Tobiasfonseca/Early-Fire-Detection-System/README.md

# Early-Fire-Detection-System
Sistema para detección temprana de incendios.
