Tobiasfonseca/Early-Fire-Detection-System/Informe_EFDS.pdf

Diseno de Sistema para la Detecci ˜ | on Temprana de ´ Incendios Forestales

Tobías Fonseca Cruz
Escuela de Ingeniería Electronica ´ Instituto Tecnologico de Costa Rica ´ Cartago, Costa Rica
tobiasfonsecac@gmail.com

Resumen—El informe presenta el desarrollo y resultados de
la primer version de un sistema para la detecci ´ | on temprana de ´
incendios forestales. Utiliza sensores de gases, humedad relativa y temperatura, y es alimentado por una batería de litio. Mediante un ESP32 se suben los datos a una base de datos en caso de
exceder los parametros definidos. El sistema funcion ´ | o seg ´ | un lo ´
esperado y da paso a una siguiente version que busque ser ´ mas eficiente en el consumo de potencia y buscar mejoras en ´ el programa y el PCB.

Palabras Clave—DHT22, DS18B20, ESP32, MQ2, WiFi

I. INTRODUCCION´

La Comision Nacional de Emergencias (CNE) define un ´ incendio forestal como un fuego que se propaga sin control
a traves de vegetaci ´ | on rural o urbana y pone en peligro a las ´
personas, los bienes y el medio ambiente, estos constituyen
la causa mas importante de destrucci ´ | on de bosques [1]. En ´
ocasiones pueden durar poco tiempo, sin embargo si se presentan las condiciones adecuadas el incendio puede ser de gran magnitud y propagarse rapidamente [2]. ´
El inicio de un incendio forestal puede ser de 3 orígenes: forma malintencionada, fortuitamente o natural. La mayoría de las veces se dan como consecuencia de acciones humanas tales como deforestacion, agricultura y negligencia. Dentro de ´ las repercusiones de los incendios forestales se encuentran la
emision de gran cantidad de contaminantes, holl ´ | ín que puede
ser transportado grandes distancias y generar que los sumideros de carbono se conviertan en fuentes de gas invernadero [2].
Debido a la crisis climatica, se espera que para el 2050 ´ la cantidad de incendios forestales aumente en un 30 %, por lo que se hace un llamado a los gobiernos para implementar
estrategias de prevencion, preparaci ´ | on y asignar presupuestos ´
adecuadamente ante tal fenomeno. Los pa ´ | íses pobres se ven
afectados de gran manera por la poca capacidad de respuesta y por el alto costo de la reconstruccion de las zonas afectadas ´ [3].
El Sistema de Alerta Temprana de Incendios Forestales (SATIF) del Instituto Meteorologico Nacional de Costa Rica ´ permite evaluar variables que afectan la probable ocurrencia y potencial comportamiento del fuego. El proyecto surge de la donacion del Fondo Cooperativo para el Carbono de los ´ Bosques (FCPF) y ademas de obtener las condiciones de ´
riesgo, busca crear una cultura y educacion en la poblaci ´ | on´
para evitar la ocurrencia de incendios. El SATIF es capaz de medir la temperatura, la humedad relativa, velocidad del viento y cantidad de lluvia. Segun estas variables, clasifica el riesgo ´ de un potencial incendio para predecir características como la velocidad de avance, altura de las llamas, entre otros [4].
El sistema pretende mejorar las soluciones existentes anadiendo la capacidad de detectar gases producidos por ˜ la combustion de los incendios forestales. Busca ser una ´
alternativa de bajo costo, autonoma y de f ´ | acil integraci ´ | on´
que permita ser instalada en zonas propensas a incendios por entidades como bomberos u organizaciones interesadas.

II. METODOLOGÍA

A continuacion, se dar ´ | a una descripci ´ | on detallada del dise ´ | nõ
y seleccion de componentes para la medici ´ | on de variables, ´
transmision de la informaci ´ | on y distribuci ´ | on de potencia. ´

II-A. Sensores
Las variables por medir corresponden a temperatura, humedad relativa y gases provocados en incendios.
Temperatura: El sensor DS18B20 permite medir temperatura con una resolucion de 9 (0.5°C) a 12 bits ´ (0.0625°C), un rango de medicion de -55°C hasta ´ +125°C, fuente de voltaje de 3 a 5.5V. Este sensor trabaja con el protocolo 1-Wire, cuya salida digital se conecta a Vcc mediante una resistencia de pull-up. Para mas detalles ´ consultar su hoja de datos. (https://dlnmh9ip6v2uc.cloudfront.net/datasheets/Sensors/Temp/DS18B20.pdf)
Humedad relativa: El sensor DHT22 permite medir la
humedad relativa con una precision de ´ | ±2 % y una
resolucion de ´ | ±0.1 %. Es capaz de trabajar con fuentes de
3.3 a 6V. Ademas, permite leer temperatura sin embargo ´ con una resolucion menor comparada al DS18B20 ante- ´ riormente mencionado. El sensor transmite datos a traves´ de una salida digital conectada a Vcc con una resistencia
de pull-up. Para mas detalles consultar su ´ | hoja de datos. (https://cdn-shop.adafruit.com/datasheets/DHT22.pdf)
Gases: Algunos de los contaminantes que se emiten
durante la combustion de biomasa corresponden a di ´ | oxi- ´
do de carbono, monoxido de carbono, metano, hidro- ´ carbonos y partículas de humo [5]. Por tanto, se opta por el sensor MQ2, el cual es sensible a gases como alcohol, propano, monoxido de carbono, metano, gas ´ LPG y humo. El sensor opera a 5V y necesita de un precalentamiento recomendado de 48 horas. Su consumo de potencia es menor a 800mW y permite una resistencia de carga ajustable. A diferencia de los sensores de temperatura y humedad, el MQ2 tiene una salida analogica ´
en funcion de la concentraci ´ | on del gas detectado. En la ´
Figura 1 se muestran las curvas de sensitividad del sensor
ante distinto gases. Para mas detalles consultar su ´ | hoja
de datos. (https://www.mouser.com/datasheet/2/321/605-00008-MQ-2-Datasheet-370464.pdf)

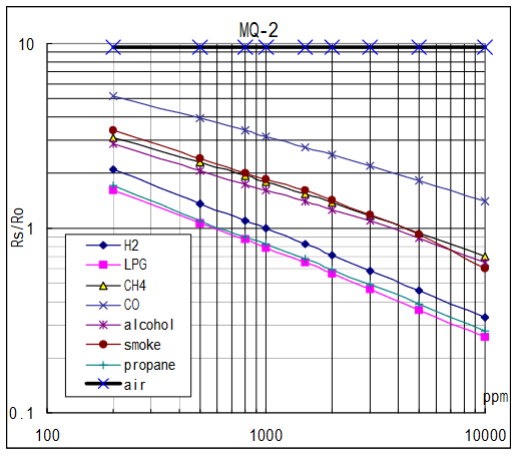
[picture p1: figure]

Figura 1. | Características de sensitividad de sensor MQ2. Medidas a 20°C,
humedad 65 %, concentracion de ox ´ | ígeno 21 % y RL = 5kΩ.

II-B. Microcontrolador
El microcontrolador ESP32 DevKit V1 de 30 pines contiene gran diversidad de funcionalidades en sus puertos como GPIO, ADC, Touch, PWM, UART, I2C, entre otros. Ademas, cuenta ´
con un modulo de WiFi y BLE integrado, ADC con resoluci ´ | on´
de 12 bits, tamano reducido; por lo que es una opci ˜ | on favorable ´
frente a otros microcontroladores como el Arduino UNO.

II-C. Potencia
Para determinar los componentes requeridos para alimentar tanto los sensores como el microcontrolador es importante definir los voltajes de operacion de cada uno de los componentes: ´

Cuadro I
VOLTAJES DE OPERACION DE LOS COMPONENTES ´
Componente | Voltaje (V)
ESP32 | 7-12
DHT22 | 3.3-6
DS18B20 | 3-5.5
MQ2 | 5

Por tanto, los sensores DHT22 y DS18B20 se pueden alimentar de la salida a 3.3V del ESP32. Se requiere de una
alimentacion de m ´ | ínimo 7V para el ESP32 y otra alimentacion´
de 5V para el sensor MQ2.

Primero, para obtener la fuente de 7V:
Batería: se necesita una batería de gran capacidad para poder alimentar el sistema durante la noche, por lo que se opta por una batería de polímero de litio de 6600mAh (enlace). (https://www.crcibernetica.com/lithium-ion-battery-pack-3-7v-6600mah/)
BMS (Battery Management System): para cargar y distribuir la potencia de la batería se escoge la placa Sunny Buddy (https://www.sparkfun.com/products/12885) de Sparkfun, la cual permite la carga con panel solar.
Buck converter: es necesario para elevar el voltaje de salida de la batería a 7V requeridos por el ESP32. El convertidor escogido corresponde al XL6009E1, (https://www.crcibernetica.com/dc-dc-boost-buck-converter-step-up-and-step-down/) este permite un rango de entrada de 3.5V a 30V y uno de salida de 5V a 30V.
Para obtener la fuente de 5V se agrega un regulador de voltaje LM7805 (https://www.sparkfun.com/datasheets/Components/LM7805.pdf) conectado a la fuente de 7V ya disenada. Se ˜ utiliza el circuito de la Figura 2 para proveer de energía al sensor MQ2.

Figura 2. Regulador de salida fija

II-D. Diagrama esquematico ´

En la Figura 3 se muestra el diagrama de conexion utilizado. ´
A continuacion se da una breve descripci ´ | on de las terminales ´
y componentes:
J2: corresponde a la entrada de voltaje proveniente del BMS.
JP3, JP4, JP5 y JP6: corresponden a los puertos de conexion para el buck converter. ´
SW1: switch de dos estados para encender o apagar todo el sistema.
SW2: switch de proteccion para desconectar el ESP32 ´ de la alimentacion en caso que se necesite utilizar la ´ conexion por USB. ´
R1 (2.7kΩ) y R2 (3.3kΩ): divisor de voltaje para acondicionar la senal de salida de 5V a 3.3V, esto debido a ˜ que el ESP32 trabaja con voltajes de 3.3V, si se aplica un voltaje mayor se corre el riesgo de danarlo. ˜
R3 y R4 (4.7kΩ): ambas resistencias de pull-up para los sensores DS18B20 y DHT22, respectivamente.
C1 (0.33µF) y C2 (0.1µF): capacitores para la fuente regulada de 5V, como se muestra en el diagrama de la Figura 2.
Para la conexion de la entrada de voltaje y los sensores ´ (MQ2, DS18B20 y DHT22) se utilizan terminales de tornillo de 2 y 3 pines segun correspondan. Para el ESP32 se utilizan ´
pinhead hembras que permitan la facil conexi ´ | on y desconexi ´ | on´
de la placa.

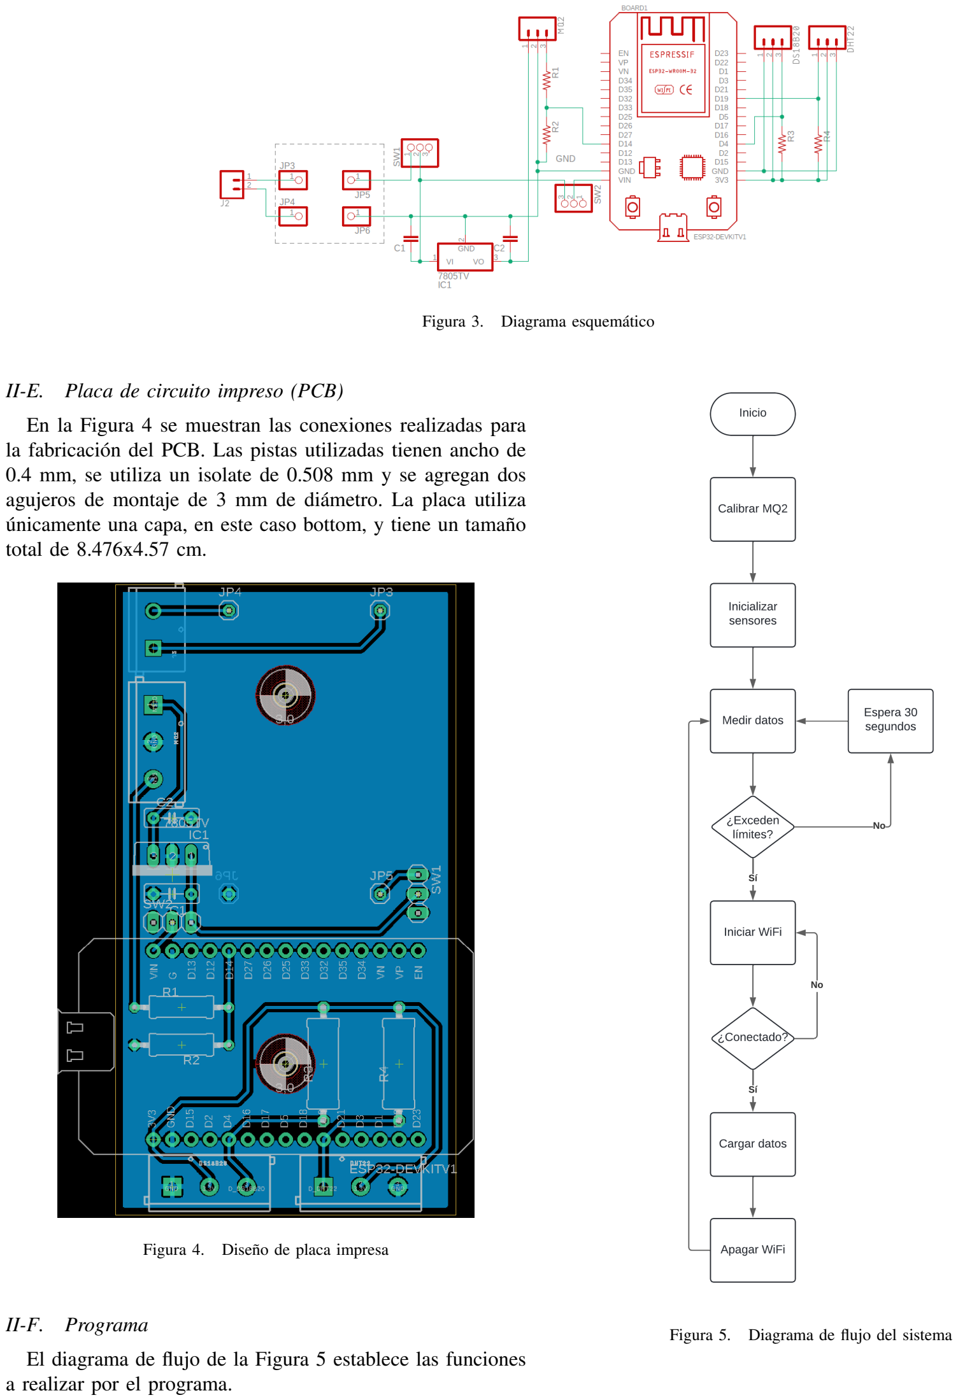
[picture p2: page 3]

Figura 3. Diagrama esquematico ´

II-E. Placa de circuito impreso (PCB)

En la Figura 4 se muestran las conexiones realizadas para la fabricacion del PCB. Las pistas utilizadas tienen ancho de ´ 0.4 mm, se utiliza un isolate de 0.508 mm y se agregan dos agujeros de montaje de 3 mm de diametro. La placa utiliza ´
unicamente una capa, en este caso bottom, y tiene un tama ´ | nõ
total de 8.476x4.57 cm.

Figura 4. Diseno de placa impresa ˜

II-F. Programa

El diagrama de flujo de la Figura 5 establece las funciones a realizar por el programa.

Figura 5. Diagrama de flujo del sistema

Como se observa, para que se envíe un dato alguna de las tres variables deben exceder los límites excedidos. En este caso se definen los siguientes:
Temperatura mayor a 40°C
Humedad relativa menor a 30 %
Concentracion de part ´ | ículas de humo mayor a 1000ppm
En el momento que se exceda al menos uno de los límites definidos, la placa activa el modulo de WiFi para conectarse ´ a la red definida. Es necesario asegurarse de una correcta
conexion, por lo que se debe verificar el estado de la conexi ´ | on. ´
Si se conecto a la red, se procede a cargar los valores a la base ´ de datos, se apaga el WiFi y vuelve a medir.
El programa utilizado, codigos de apoyo y archivos de Eagle ´ se encuentran en el repositorio al cual se puede acceder con el siguiente enlace. (https://github.com/Tobiasfonseca/Early-Fire-Detection-System.git)
III. ANALISIS DE ´ | RESULTADOS

Al realizar pruebas iniciales con los componentes montados en protoboard fue posible observar perdidas de voltaje pro- ´ vocadas por la misma protoboard y los jumpers. Esto afectó principalmente al sensor MQ2 dado que su salida es analogica. ´ Los sensores DHT22 y DS18B20 no presentaron problemas al ser utilizados en protoboard. Para evitar los problemas de
perdidas se decidi ´ | o proceder con la manufactura de la placa ´
impresa.
Una vez soldados los componentes en la placa (Figura 6), al realizar las primeras pruebas aun hubo problema para leer ´ datos del sensor MQ2. Tras indagar en la documentacion del ´ ESP32, el microcontrolador posee dos bloques ADC, uno de ellos se reserva para ser usado por el modulo WiFi que a su ´ vez estaba siendo utilizado para hacer lectura del sensor MQ2. Para solucionarlo, el programa se modifico de tal manera que ´ primero hace lectura de los datos, verifica si esta fuera de ´ rango y si lo esta activa el WiFi para enviar los datos. ´

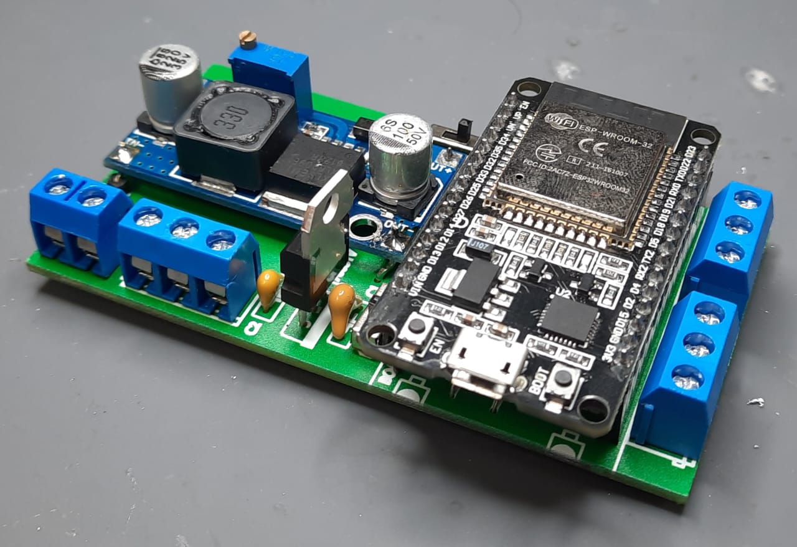
[picture p3: figure]

Figura 6. Componentes montados y soldados en placa impresa

En cuanto a potencia, el sistema logra funcionar correctamente con la batería de litio seleccionada durante varias horas.

La medicion de las variables y el env ´ | ío hacia la base de
datos es correcta. En la Figura 7 se muestra un ejemplo de los dtos obtenidos.

Figura 7. Recepcion en la base de datos ´

IV. CONCLUSIONES Y RECOMENDACIONES
Para evitar problemas entre el modulo WiFi y el sensor MQ2, es preferible hacer lectura con el primer bloque de ADC del ESP32. Esto implica modificar el pin tanto en el programa como en la placa impresa.
Corregir la ubicacion de pines del Buck Converter, ya ´ que no fue exacta y fue necesario adaptar pines para poder conectarlo a la placa impresa.
Utilizar una distinta base de datos que permita la comunicacion sin necesidad de tener una computadora adicional como ´ host.
Realizar pruebas con panel solar y batería para verificar el funcionamiento durante las 24 horas del sistema. Aunque la batería es de alta capacidad, es necesario analizar el comportamiento del sistema tanto en días soleados como nublados para determinar si se necesita una batería de mayor capacidad o hacer mas eficiente el consumo de potencia del sistema ´

REFERENCIAS

[1] Comision Nacional de Emergencias. ¿qu ´ | | e es un incendio forestal? ´
[Online]. | Available: | https://cne.go.cr/reduccion riesgo/informacion
educativa/recomentaciones consejos/incendio forestal.aspx (https://cne.go.cr/reduccion_riesgo/informacion_educativa/recomentaciones_consejos/incendio_forestal.aspx)
[2] ¿que es un incendio forestal y por qu ´ | | e es tan peligroso? [Online]. ´
Available: https://www.nationalgeographicla.com/medio-ambiente/2024/02/que-es-un-incendio-forestal-y-por-que-es-tan-peligroso (https://www.nationalgeographicla.com/medio-ambiente/2024/02/que-es-un-incendio-forestal-y-por-que-es-tan-peligroso)
[3] Los incendios forestales aumentaran un 30 ´
[4] Sistema de alerta temprana de incendios forestales (satif). [Online]. Available: https://www.imn.ac.cr/alerta
[5] R. W. Manso-Jimenez. Emisiones de gases y part ´ | ículas producto
de los incendios forestales en cuba entre 1989 y 1999. [Online]. Available: https://www.produccion-animal.com.ar/incendios y uso del fuego/41-gases.pdf (https://www.produccion-animal.com.ar/incendios_y_uso_del_fuego/41-gases.pdf)
