Tobiasfonseca/Early-Fire-Detection-System/Eagle/ESFDv1.brd

## EAGLE design Eagle/ESFDv1.brd (2024-08-22)

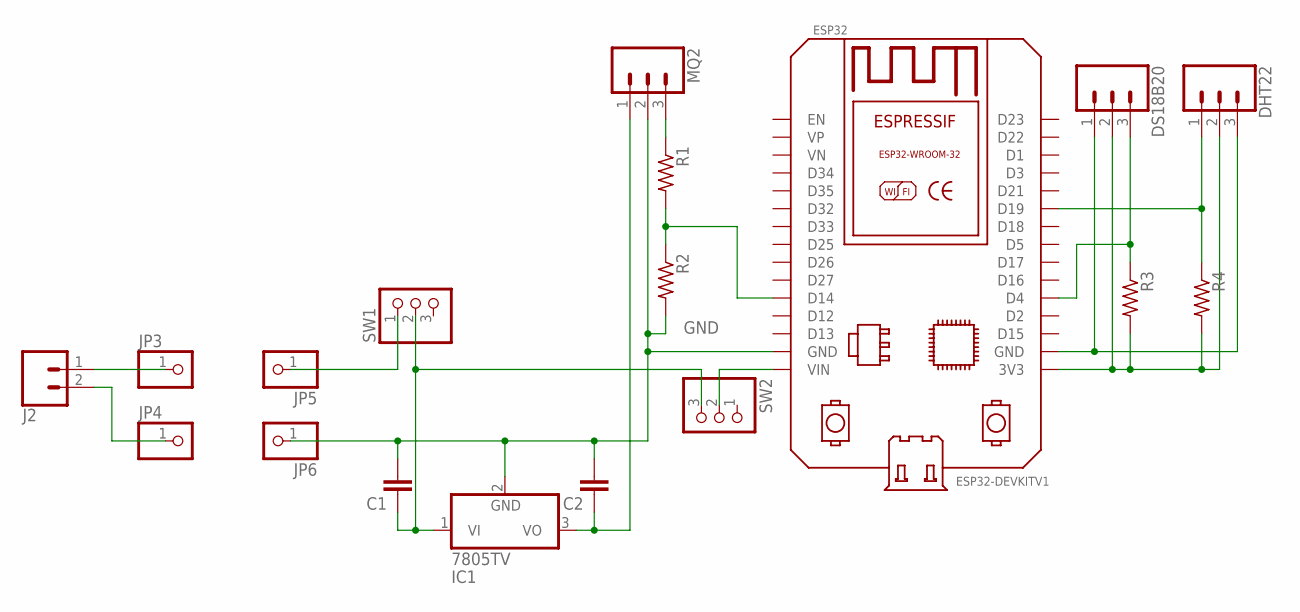
[picture p4: schematic ESFDv1.sch]

Parts:
C1, C2: C5/2.5; C5B2.5
DHT22: CONN_03-SCREW-5MM; SCREWTERMINAL-5MM-3
DS18B20: CONN_03-SCREW-5MM; SCREWTERMINAL-5MM-3
ESP32: ESP32DEVKITV1; ESP32-DEVKITV1
IC1: 7805TV; TO220V
J2: CONN_025MM; SCREWTERMINAL-5MM-2
JP3, JP4, JP5, JP6: PINHD-1X1; 1X01
MQ2: CONN_03-SCREW-5MM; SCREWTERMINAL-5MM-3
R1, R2: R-US_0309/12; 0309/12
R3, R4: R-US_0414/15; 0414/15
SW1, SW2: PINHD-1X3; 1X03

Connections:
3.3V: DHT22.2, DS18B20.2, ESP32.3V3, R3.2, R4.2
D_DHT22: DHT22.1, ESP32.D19, R4.1
D_DS18B20: DS18B20.3, ESP32.D4, R3.1
GND: C1.2, C2.2, DHT22.3, DS18B20.1, ESP32.GND, ESP32.GND@1 (GND), IC1.2 (GND), JP6.1, MQ2.2, R2.2
unnamed: J2.1, JP3.1
unnamed: J2.2, JP4.1
unnamed: JP5.1, SW1.1
unnamed: MQ2.3, R1.1
unnamed: ESP32.D14, R1.2, R2.1
unnamed: C1.1, IC1.1 (VI), SW1.2, SW2.3
unnamed: ESP32.VIN, SW2.2
unnamed: C2.1, IC1.3 (VO), MQ2.1

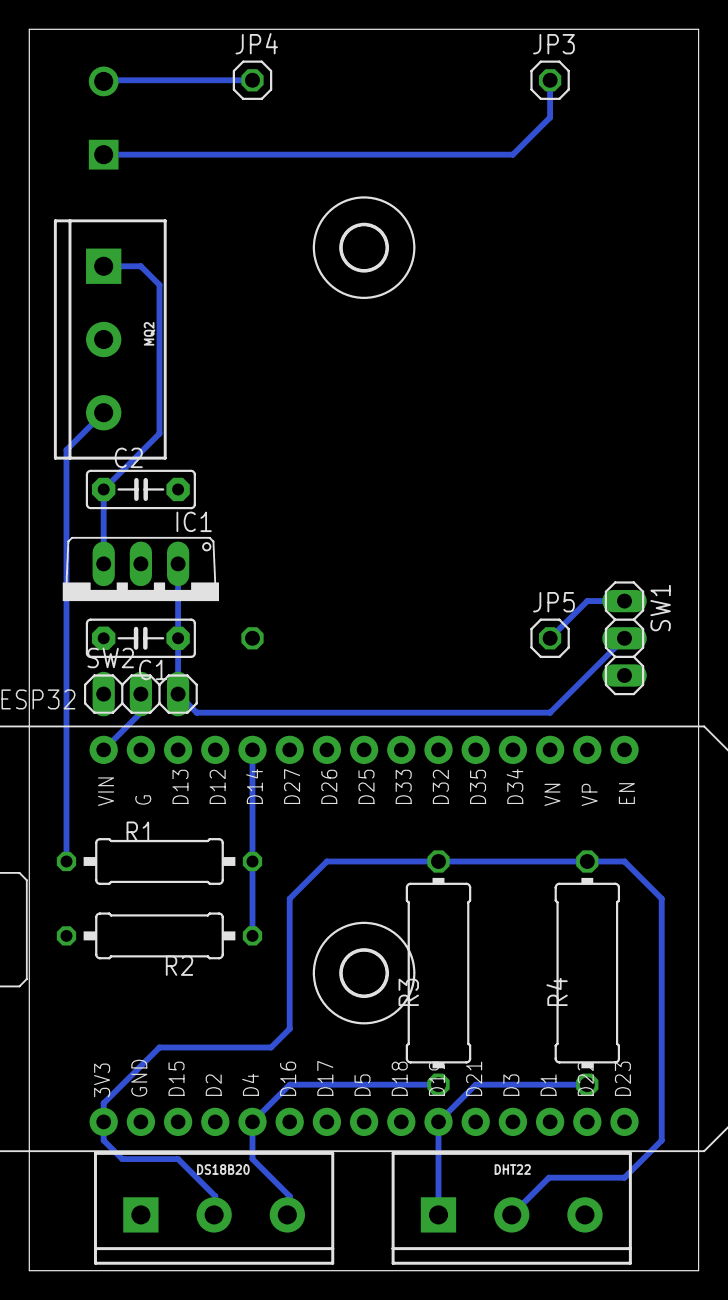
[picture p5: board ESFDv1.brd from above]

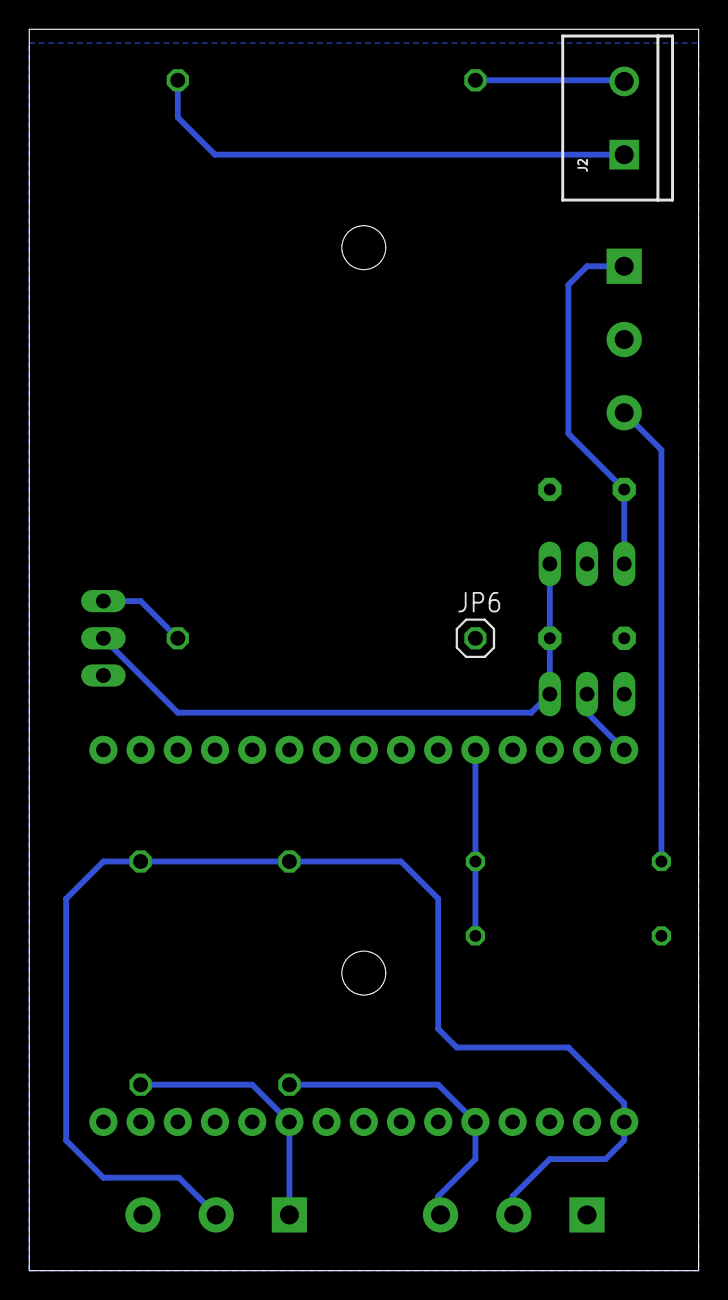
[picture p6: board ESFDv1.brd from below]

Board: 2 copper layers, 45.7 x 84.8 mm, 20 parts (2 on the bottom side), 12 nets.

Other parts of the board:
U$1, U$2: 3,0
