Tobiasfonseca/Early-Fire-Detection-System/Support code/Interrupt/Interrupt.ino

volatile int interrupts;
int totalInterrupts;

hw_timer_t* timer = NULL;
portMUX_TYPE timerMux = portMUX_INITIALIZER_UNLOCKED;

void IRAM_ATTR onTime(){
  portENTER_CRITICAL_ISR(&timerMux);
  interrupts++;
  portEXIT_CRITICAL_ISR(&timerMux);
  Serial.println("ON TIME");
}

void setup(){
  Serial.begin(115200);
  timer = timerBegin(0, 80, true);
  timerAttachInterrupt(timer, &onTime, true);
  timerAlarmWrite(timer, 1000000, true);
  timerAlarmEnable(timer);
}


void loop(){
  if(interrupts > 0){
    portENTER_CRITICAL(&timerMux);
    interrupts--;
    portEXIT_CRITICAL(&timerMux);
    totalInterrupts++;
  }
}
